jkominek/AIOC/README.md

# go see the real repo

this is a simple modification of the original project to use
2.54mm pitch screw terminals instead of the surface mount pads
for the TRS plugs.

https://github.com/skuep/AIOC
